kludda/portable-power-station/electrical/power_station_schematic.pdf

Cable: 70, BK, 500, M10, M10;

Cable: 70, RD, 200, M10, M8;

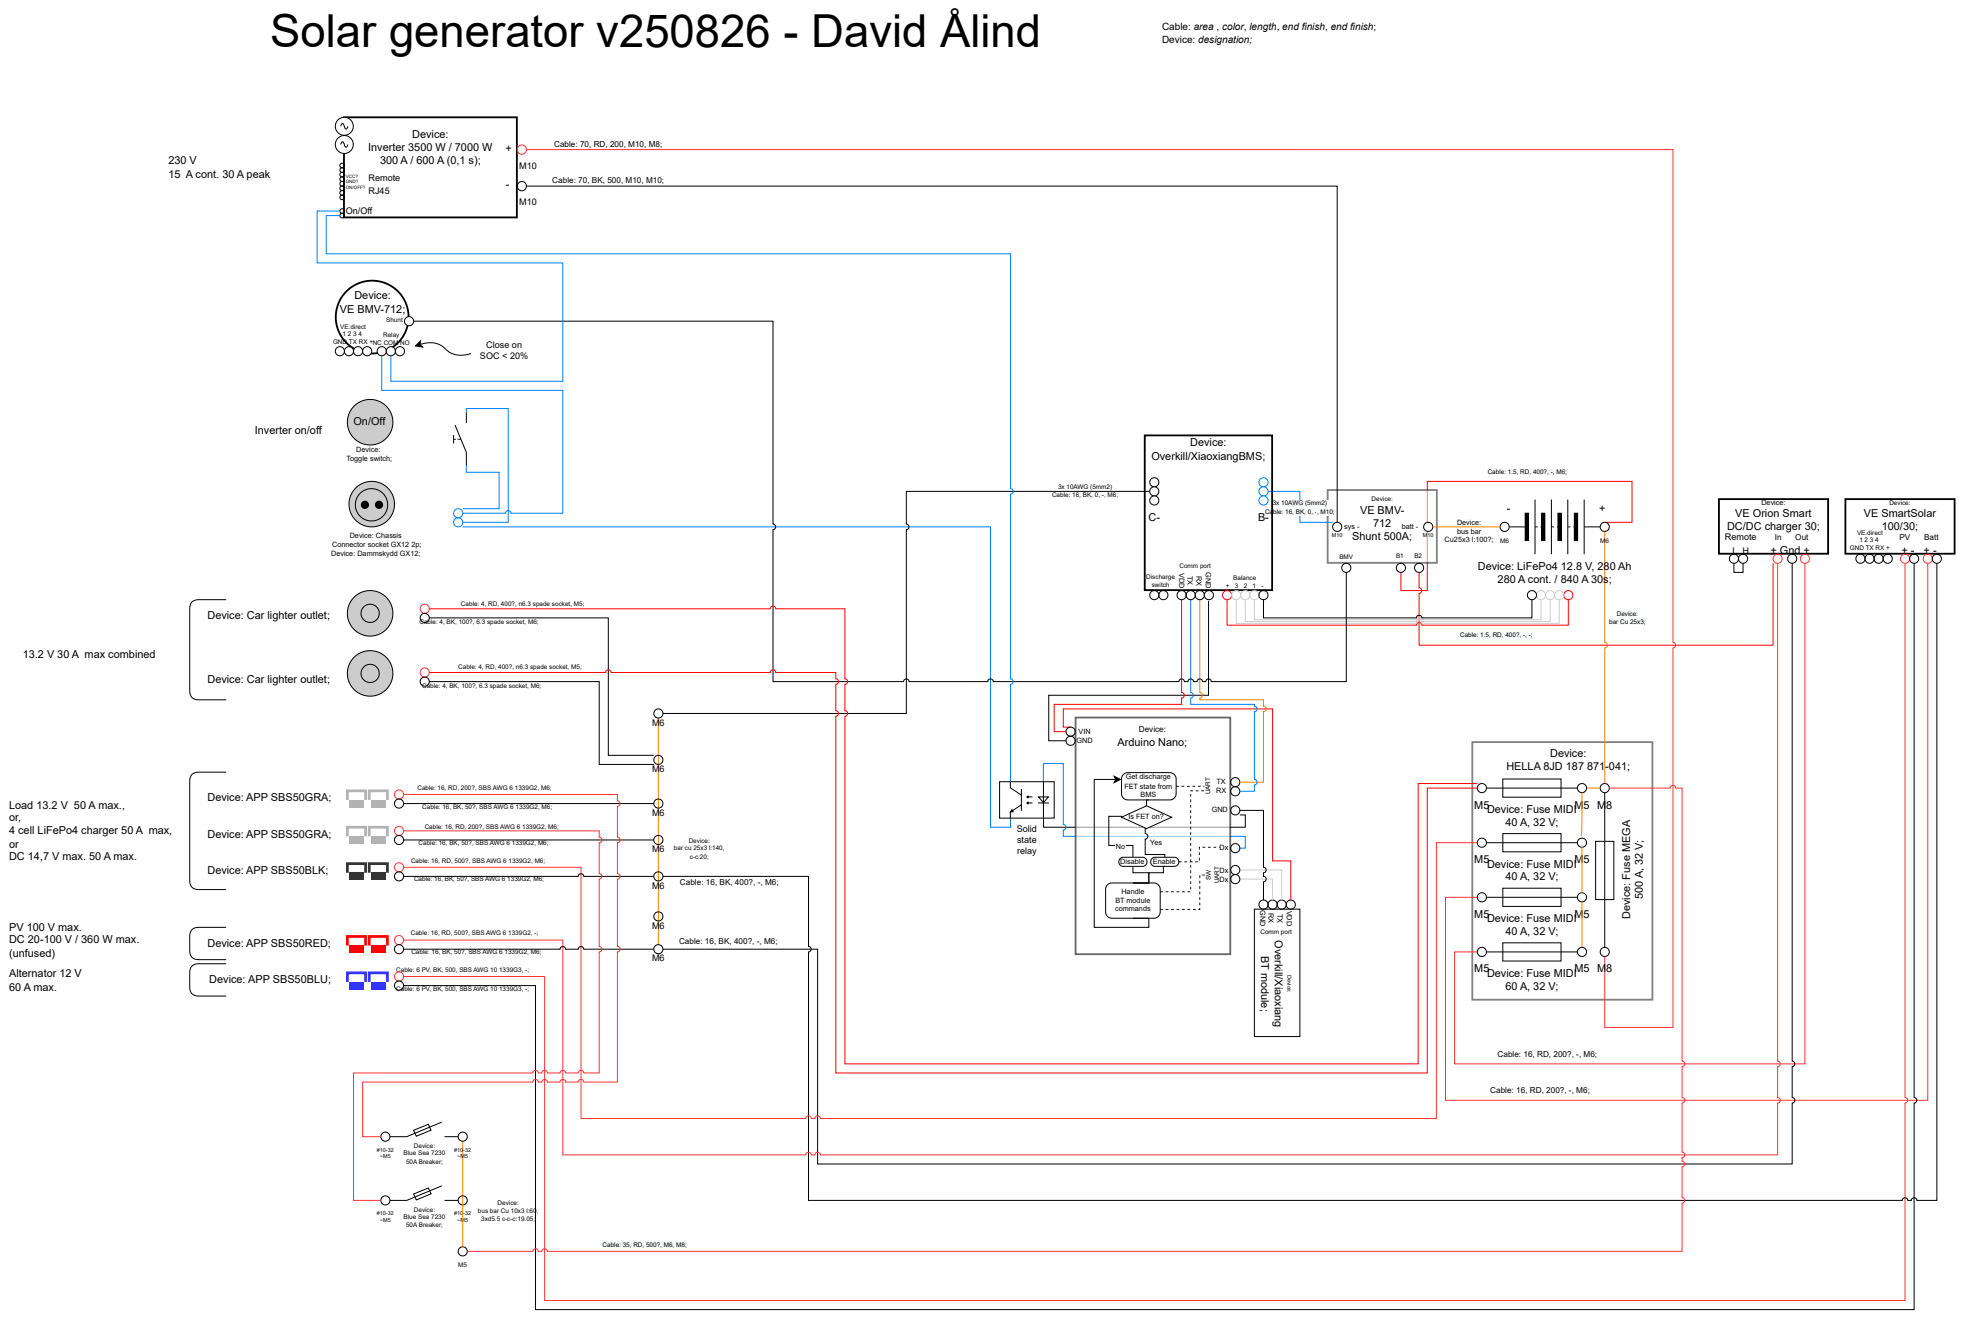
[picture p5: page 1]
Cable: 1.5, RD, 400?, -, M6;; Cable: 1.5, RD, 400?, -, -;; Device: VE BMV- 712 Shunt 500A; M10; BMV; sys -; batt -; Device: bar cu 25x3 l:140, c-c:20;; Cable: 16, RD, 200?, -, M6;; Device: VE SmartSolar 100/30;; Batt; PV 100 V max. DC 20-100 V / 360 W max. (unfused); Alternator 12 V 60 A max.; 230 V 15 A cont. 30 A peak; 13.2 V 30 A max combined; Cable: 16, BK, 400?, -, M6;; Device: bar Cu 25x3;; 3x 10AWG (5mm2) Cable: 16, BK, 0, -, M6;; Device:; Overkill/Xiaoxiang; BT module;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

Solar generator v250826 - David Ålind

Cable: area , color, length, end finish, end finish;
Device: designation;

VE.direct
GND TX RX +

Relay
NC COM NO

Inverter on/off

Device:
VE Orion Smart
DC/DC charger 30;
Remote

Comm port GND TXRX VDD

Device: Car lighter outlet;

Cable: 4, RD, 400?, n6.3 spade socket, M5;

Cable: 4, BK, 100?, 6.3 spade socket, M6;

Get discharge
FET state from
BMS

Cable: 16, RD, 200?, SBS AWG 6 1339G2, M6;

Load 13.2 V 50 A max.,
4 cell LiFePo4 charger 50 A max,
DC 14,7 V max. 50 A max.

Cable: 16, BK, 50?, SBS AWG 6 1339G2, M6;

M5 Device: Fuse MIDI

Is FET on?

Device: Fuse MEGA

Cable: 16, RD, 500?, SBS AWG 6 1339G2, M6;

Comm port VDD RXTX GND

Cable: 16, RD, 500?, SBS AWG 6 1339G2, -;

Cable: 6 PV, BK, 500, SBS AWG 10 1339G3, -;

M8 Device: Fuse MIDI
