kludda/portable-power-station/(notices)

Notices in the files:
readme.md:
License: CC-BY 4.0
